eozturk1968/eeg-frontend/docs/step1/Step1_breadboard.jpeg

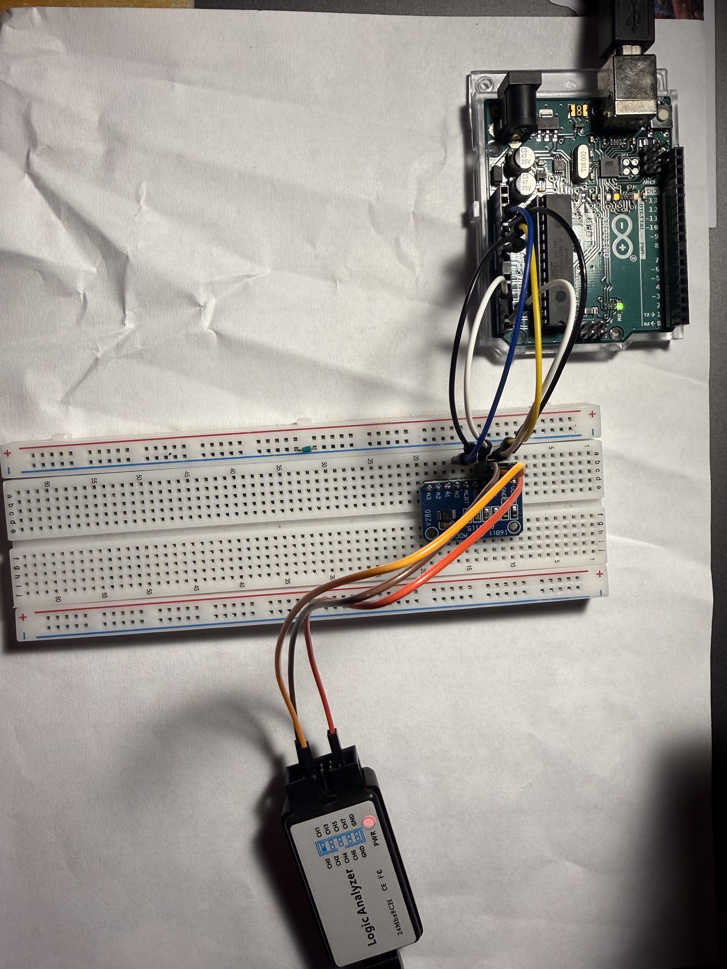
docs/step1/Step1_breadboard.jpeg
