eozturk1968/eeg-frontend/README.md

# eeg-frontend
Single-channel biopotential (EMG/ECG/EEG) analog front-end built from scratch: INA333 + ADS1115 + Arduino, with Python analysis.
