eozturk1968/eeg-frontend/docs/step1/pulseview_result.png

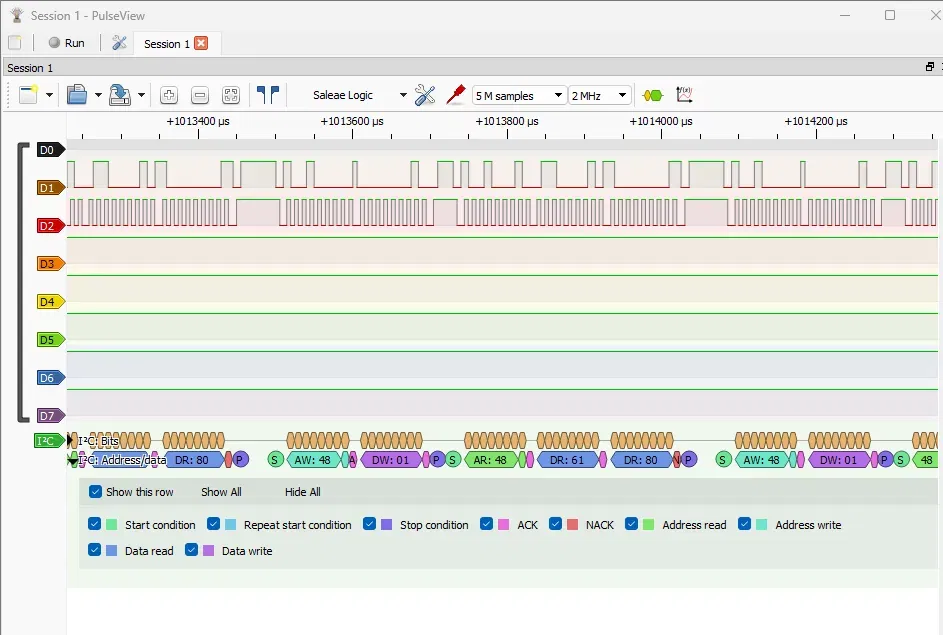
docs/step1/pulseview_result.png
