eozturk1968/eeg-frontend/docs/step2/breadboard_step2.jpg

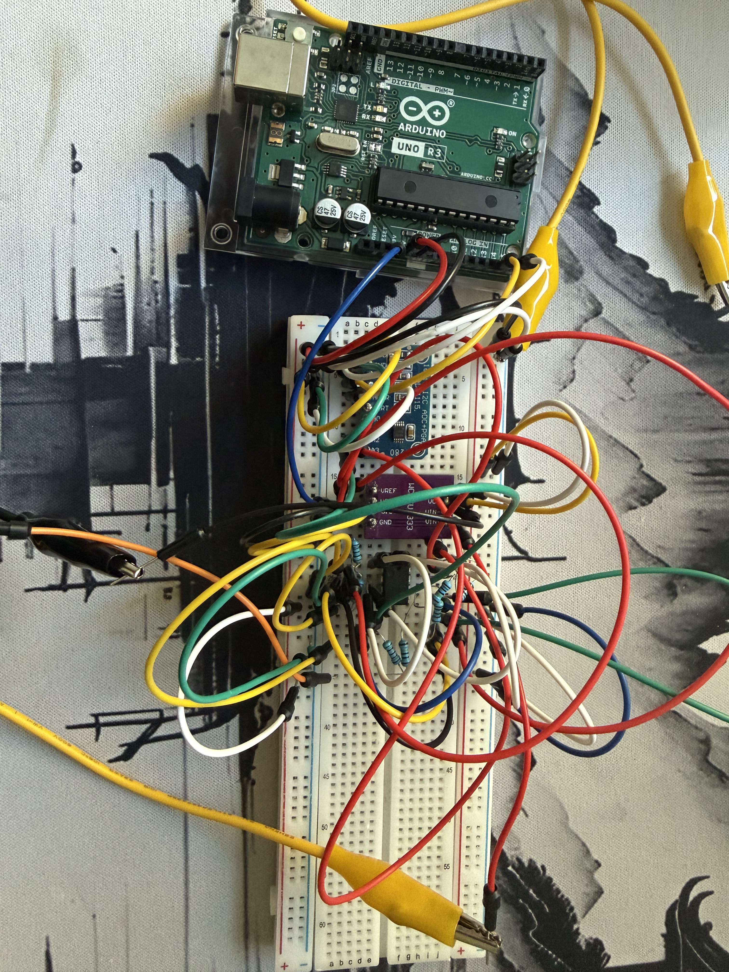
docs/step2/breadboard_step2.jpg
